DesignedbyAmpersand/ParulaKeyboard/README.md

Parula is a 100x49mm USB keyboard with 66 keys.

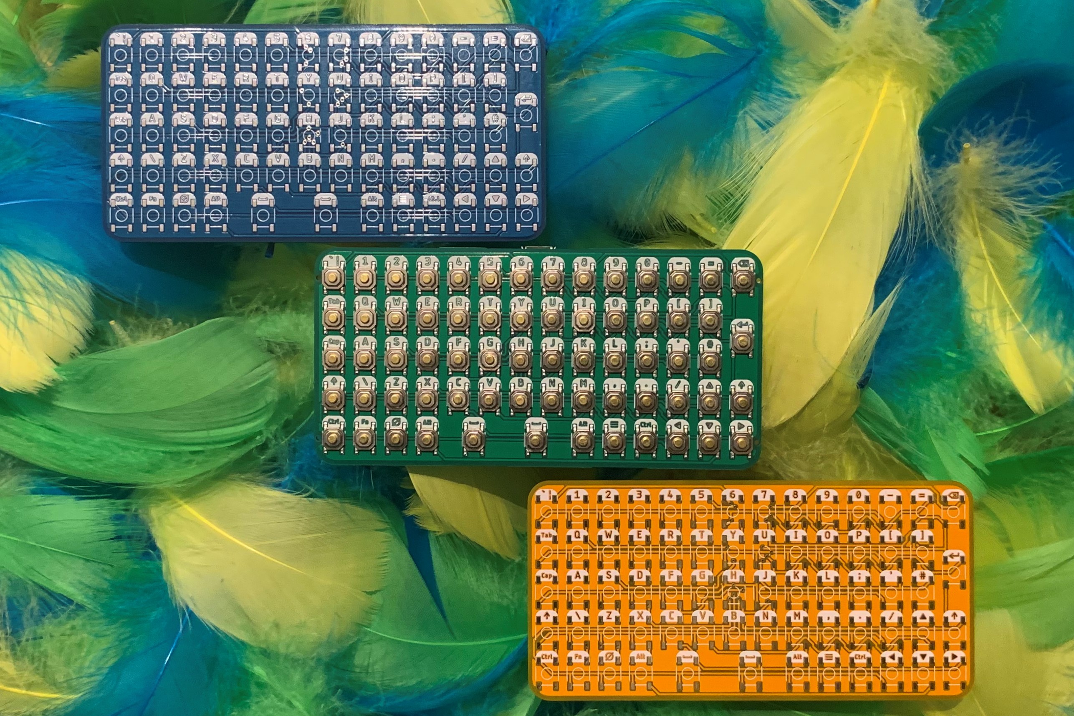
[picture p1: photos/IMG_1236cropped.jpg]
Front


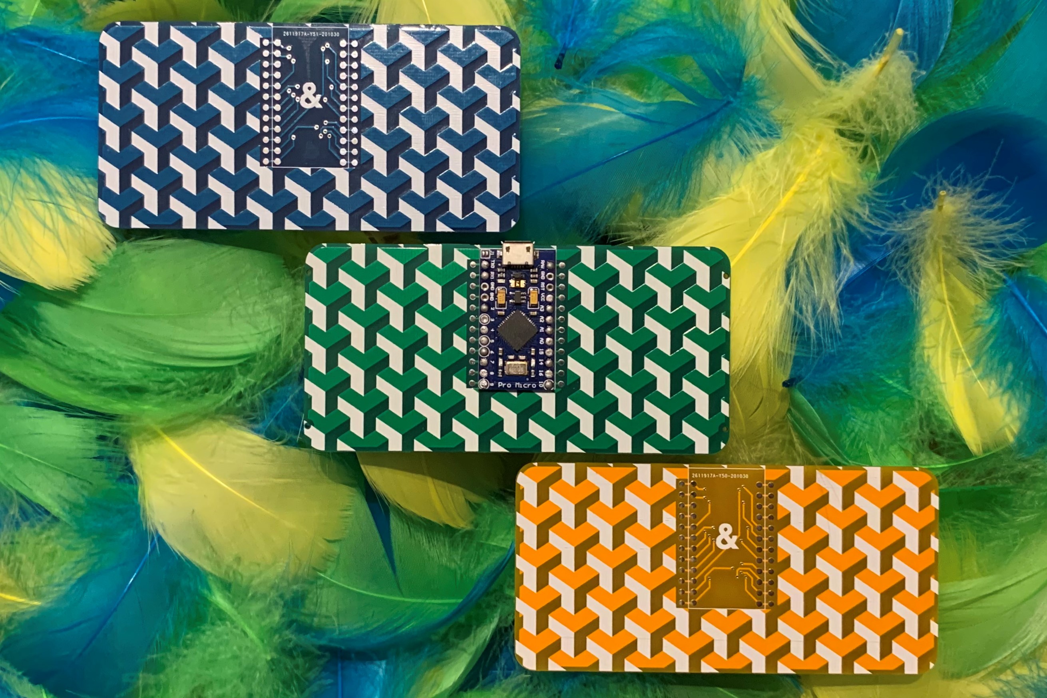
[picture p2: photos/IMG_1222cropped.jpg]
Back
