DesignedbyAmpersand/ParulaKeyboard/Parula Files V1/Parula Keymap.png

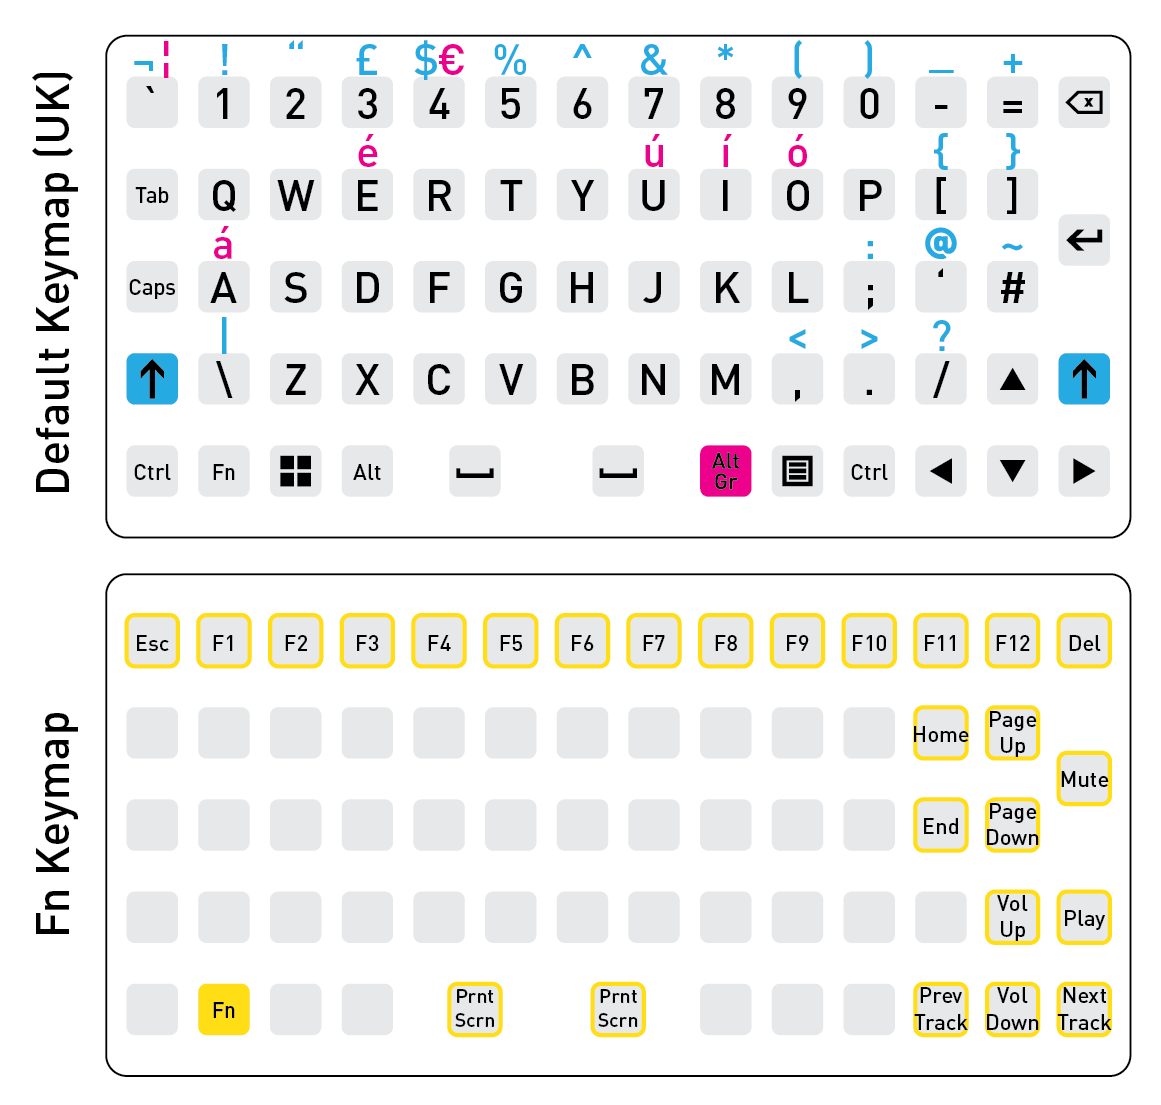
Parula Files V1/Parula Keymap.png
