DesignedbyAmpersand/ParulaKeyboard/photos/IMG_1177cropped.jpg

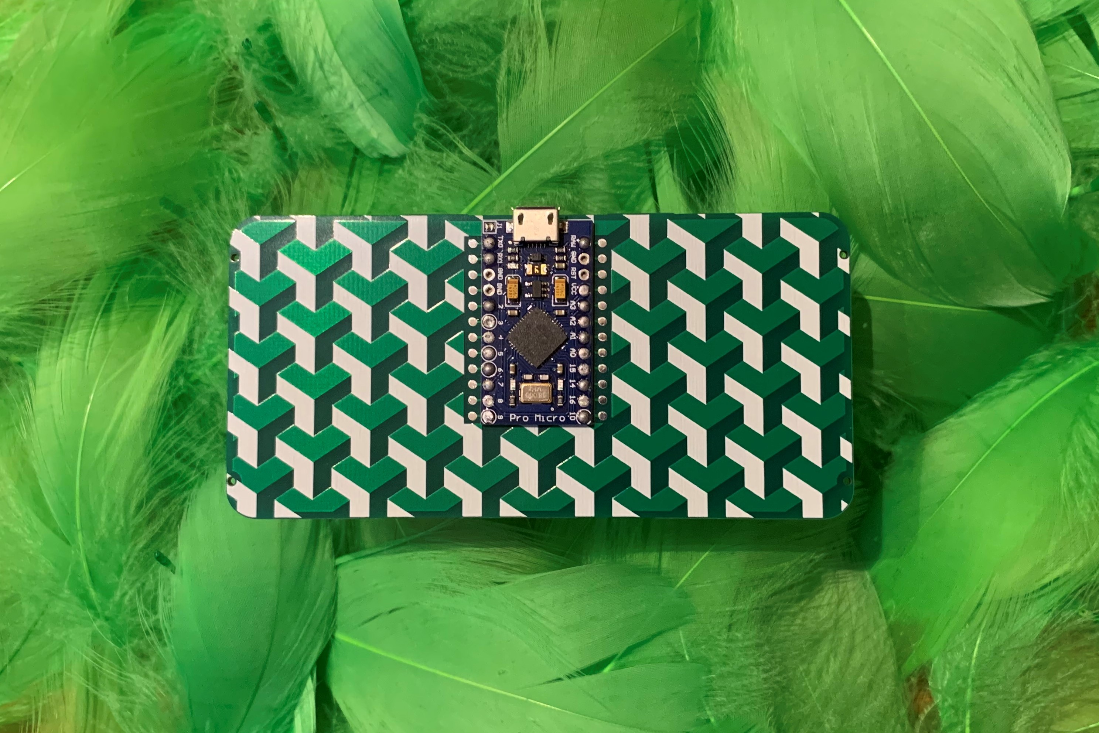
photos/IMG_1177cropped.jpg
