DesignedbyAmpersand/ParulaKeyboard/photos/IMG_1180cropped.jpg

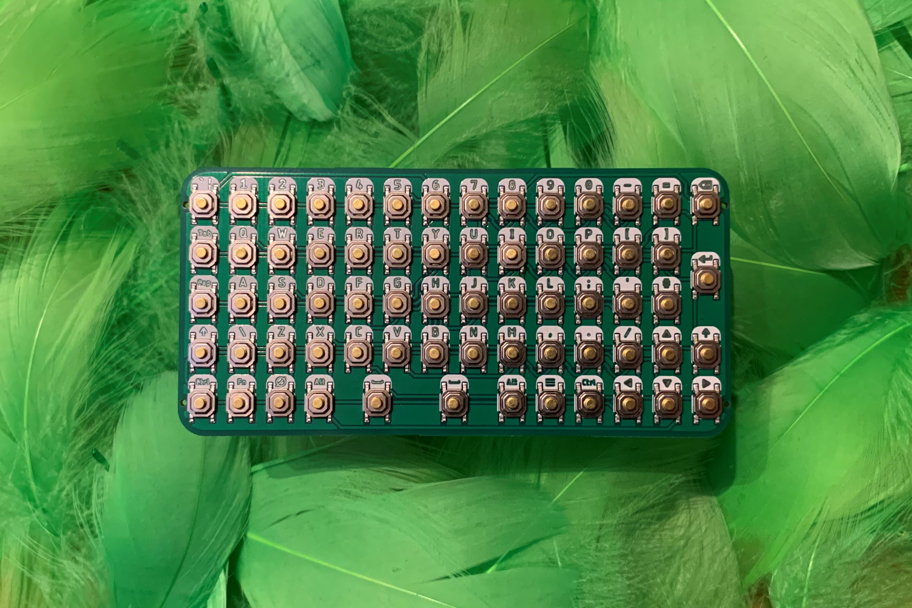
photos/IMG_1180cropped.jpg
