DesignedbyAmpersand/ParulaKeyboard/photos/IMG_1192cropped.jpg

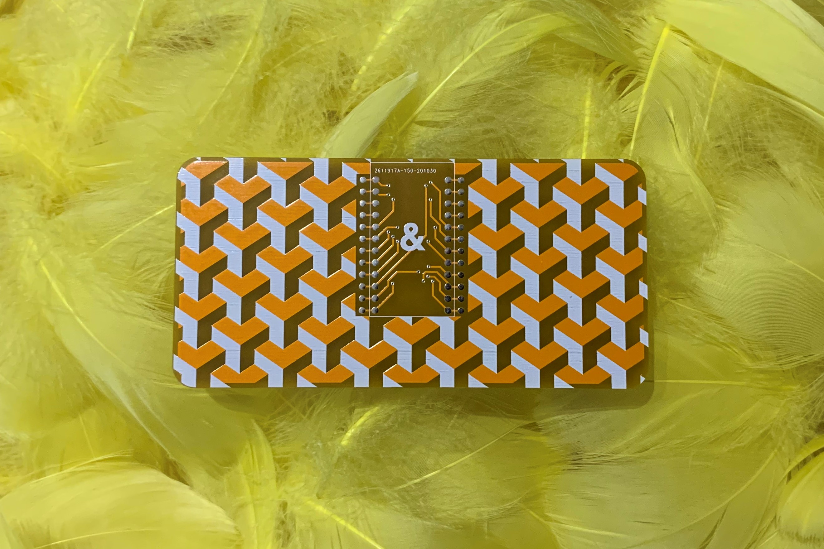
photos/IMG_1192cropped.jpg
