DesignedbyAmpersand/ParulaKeyboard/photos/IMG_1197cropped.jpg

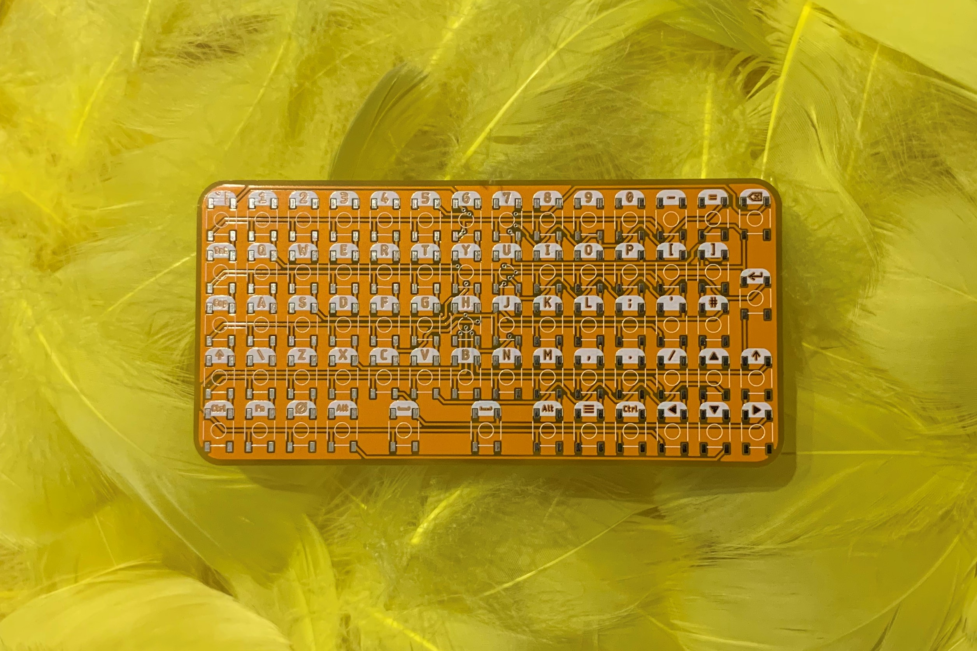
photos/IMG_1197cropped.jpg
