DesignedbyAmpersand/ParulaKeyboard/photos/IMG_1205cropped.jpg

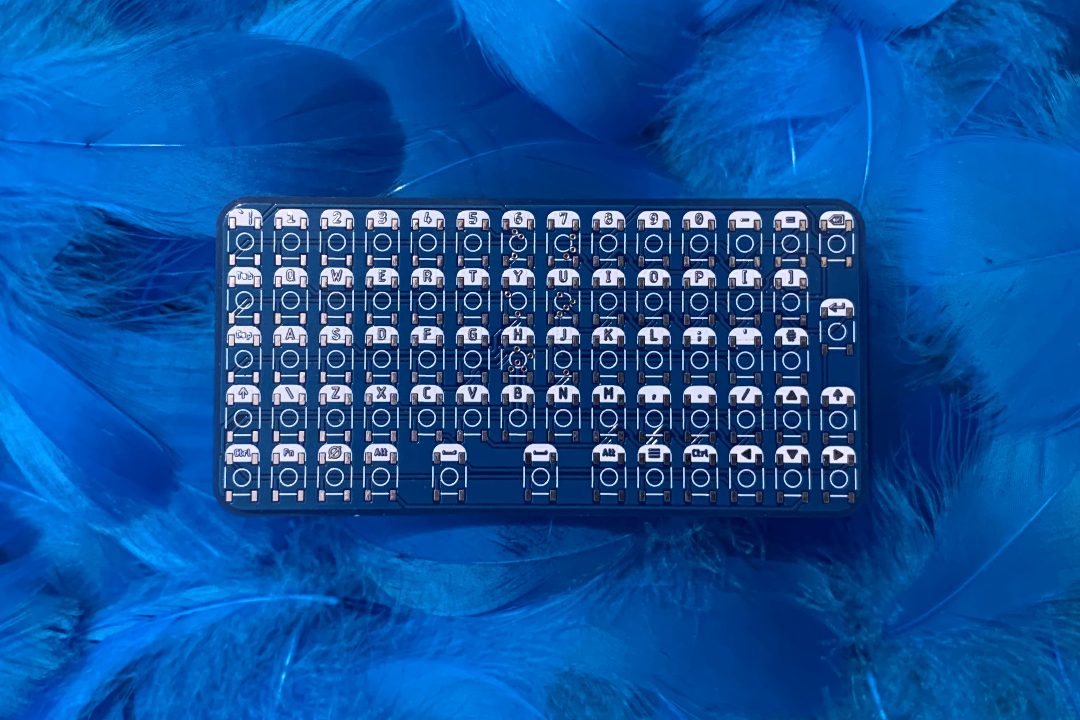
photos/IMG_1205cropped.jpg
