DesignedbyAmpersand/ParulaKeyboard/photos/IMG_1210cropped.jpg

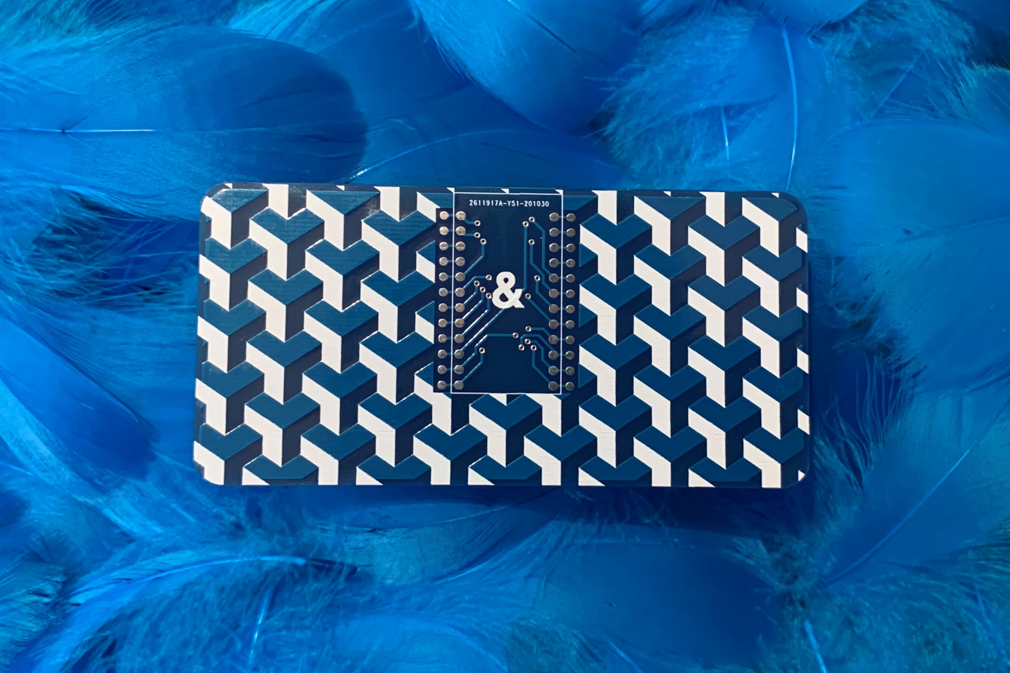
photos/IMG_1210cropped.jpg
