DesignedbyAmpersand/ParulaKeyboard/PCB/Keyboard V3.4 no holes.brd

## EAGLE design PCB/Keyboard V3.4 no holes.brd (2025-06-03)

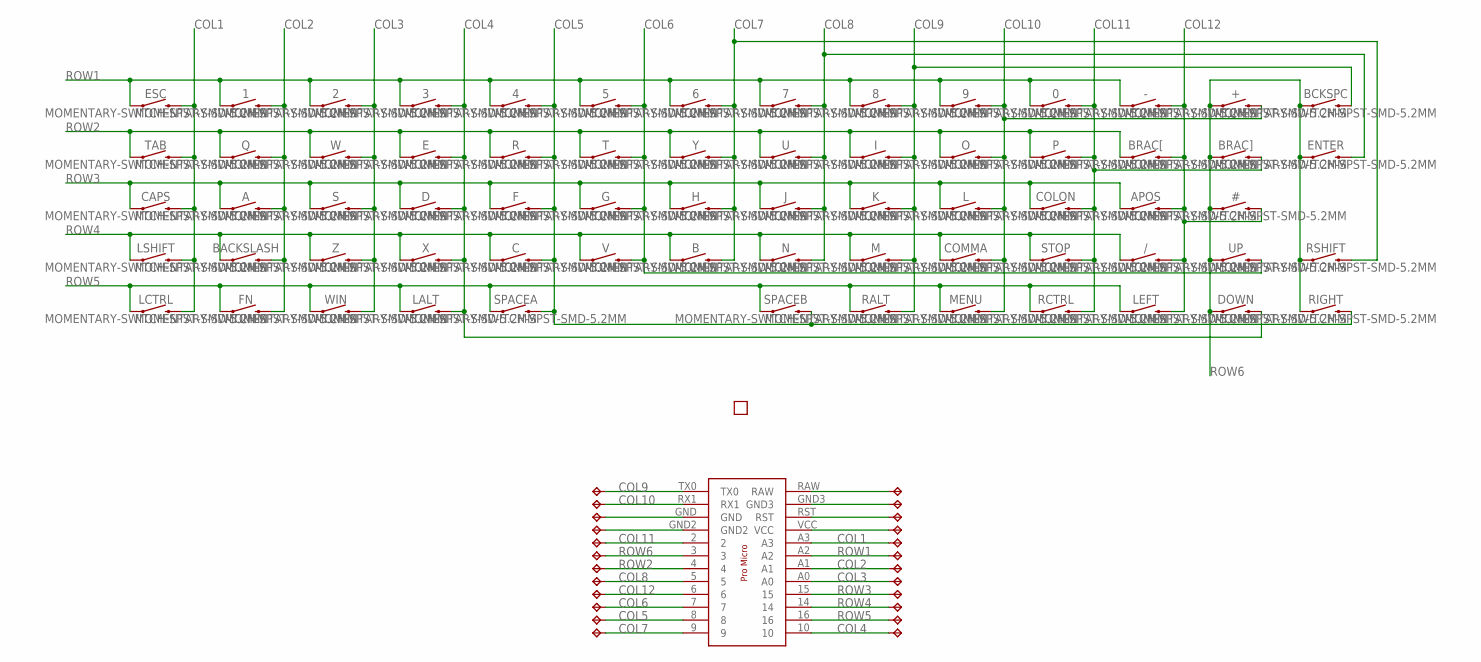
[picture p21: schematic Keyboard V3.4 no holes.sch]

Parts:
0, 1, 2, 3, 4, 5, 6, 7, 8, 9: MOMENTARY-SWITCH-SPST-SMD-5.2MM; TACTILE_SWITCH_SMD_5.2MM
#: MOMENTARY-SWITCH-SPST-SMD-5.2MM; TACTILE_SWITCH_SMD_5.2MM
+: MOMENTARY-SWITCH-SPST-SMD-5.2MM; TACTILE_SWITCH_SMD_5.2MM
-: MOMENTARY-SWITCH-SPST-SMD-5.2MM; TACTILE_SWITCH_SMD_5.2MM
/: MOMENTARY-SWITCH-SPST-SMD-5.2MM; TACTILE_SWITCH_SMD_5.2MM
A: MOMENTARY-SWITCH-SPST-SMD-5.2MM; TACTILE_SWITCH_SMD_5.2MM
APOS: MOMENTARY-SWITCH-SPST-SMD-5.2MM; TACTILE_SWITCH_SMD_5.2MM
B: MOMENTARY-SWITCH-SPST-SMD-5.2MM; TACTILE_SWITCH_SMD_5.2MM
BACKSLASH: MOMENTARY-SWITCH-SPST-SMD-5.2MM; TACTILE_SWITCH_SMD_5.2MM
BCKSPC: MOMENTARY-SWITCH-SPST-SMD-5.2MM; TACTILE_SWITCH_SMD_5.2MM
BRAC[: MOMENTARY-SWITCH-SPST-SMD-5.2MM; TACTILE_SWITCH_SMD_5.2MM
BRAC]: MOMENTARY-SWITCH-SPST-SMD-5.2MM; TACTILE_SWITCH_SMD_5.2MM
C: MOMENTARY-SWITCH-SPST-SMD-5.2MM; TACTILE_SWITCH_SMD_5.2MM
CAPS: MOMENTARY-SWITCH-SPST-SMD-5.2MM; TACTILE_SWITCH_SMD_5.2MM
COLON: MOMENTARY-SWITCH-SPST-SMD-5.2MM; TACTILE_SWITCH_SMD_5.2MM
COMMA: MOMENTARY-SWITCH-SPST-SMD-5.2MM; TACTILE_SWITCH_SMD_5.2MM
D: MOMENTARY-SWITCH-SPST-SMD-5.2MM; TACTILE_SWITCH_SMD_5.2MM
DOWN: MOMENTARY-SWITCH-SPST-SMD-5.2MM; TACTILE_SWITCH_SMD_5.2MM
E: MOMENTARY-SWITCH-SPST-SMD-5.2MM; TACTILE_SWITCH_SMD_5.2MM
ENTER: MOMENTARY-SWITCH-SPST-SMD-5.2MM; TACTILE_SWITCH_SMD_5.2MM
ESC: MOMENTARY-SWITCH-SPST-SMD-5.2MM; TACTILE_SWITCH_SMD_5.2MM
F: MOMENTARY-SWITCH-SPST-SMD-5.2MM; TACTILE_SWITCH_SMD_5.2MM
FN: MOMENTARY-SWITCH-SPST-SMD-5.2MM; TACTILE_SWITCH_SMD_5.2MM
G: MOMENTARY-SWITCH-SPST-SMD-5.2MM; TACTILE_SWITCH_SMD_5.2MM
H: MOMENTARY-SWITCH-SPST-SMD-5.2MM; TACTILE_SWITCH_SMD_5.2MM
I: MOMENTARY-SWITCH-SPST-SMD-5.2MM; TACTILE_SWITCH_SMD_5.2MM
J: MOMENTARY-SWITCH-SPST-SMD-5.2MM; TACTILE_SWITCH_SMD_5.2MM
K: MOMENTARY-SWITCH-SPST-SMD-5.2MM; TACTILE_SWITCH_SMD_5.2MM
L: MOMENTARY-SWITCH-SPST-SMD-5.2MM; TACTILE_SWITCH_SMD_5.2MM
LALT: MOMENTARY-SWITCH-SPST-SMD-5.2MM; TACTILE_SWITCH_SMD_5.2MM
LCTRL: MOMENTARY-SWITCH-SPST-SMD-5.2MM; TACTILE_SWITCH_SMD_5.2MM
LEFT: MOMENTARY-SWITCH-SPST-SMD-5.2MM; TACTILE_SWITCH_SMD_5.2MM
LSHIFT: MOMENTARY-SWITCH-SPST-SMD-5.2MM; TACTILE_SWITCH_SMD_5.2MM
M: MOMENTARY-SWITCH-SPST-SMD-5.2MM; TACTILE_SWITCH_SMD_5.2MM
MENU: MOMENTARY-SWITCH-SPST-SMD-5.2MM; TACTILE_SWITCH_SMD_5.2MM
N: MOMENTARY-SWITCH-SPST-SMD-5.2MM; TACTILE_SWITCH_SMD_5.2MM
O: MOMENTARY-SWITCH-SPST-SMD-5.2MM; TACTILE_SWITCH_SMD_5.2MM
P: MOMENTARY-SWITCH-SPST-SMD-5.2MM; TACTILE_SWITCH_SMD_5.2MM
Q: MOMENTARY-SWITCH-SPST-SMD-5.2MM; TACTILE_SWITCH_SMD_5.2MM
R: MOMENTARY-SWITCH-SPST-SMD-5.2MM; TACTILE_SWITCH_SMD_5.2MM
RALT: MOMENTARY-SWITCH-SPST-SMD-5.2MM; TACTILE_SWITCH_SMD_5.2MM
RCTRL: MOMENTARY-SWITCH-SPST-SMD-5.2MM; TACTILE_SWITCH_SMD_5.2MM
RIGHT: MOMENTARY-SWITCH-SPST-SMD-5.2MM; TACTILE_SWITCH_SMD_5.2MM
RSHIFT: MOMENTARY-SWITCH-SPST-SMD-5.2MM; TACTILE_SWITCH_SMD_5.2MM
S: MOMENTARY-SWITCH-SPST-SMD-5.2MM; TACTILE_SWITCH_SMD_5.2MM
SPACEA: MOMENTARY-SWITCH-SPST-SMD-5.2MM; TACTILE_SWITCH_SMD_5.2MM
SPACEB: MOMENTARY-SWITCH-SPST-SMD-5.2MM; TACTILE_SWITCH_SMD_5.2MM
STOP: MOMENTARY-SWITCH-SPST-SMD-5.2MM; TACTILE_SWITCH_SMD_5.2MM
T: MOMENTARY-SWITCH-SPST-SMD-5.2MM; TACTILE_SWITCH_SMD_5.2MM
TAB: MOMENTARY-SWITCH-SPST-SMD-5.2MM; TACTILE_SWITCH_SMD_5.2MM
TP1, TP2, TP3, TP4, TP5, TP6, TP7, TP8, TP9, TP10, TP11, TP12, TP13, TP14, TP15, TP16, TP17, TP18, TP19, TP20, TP21, TP22, TP23, TP24: TPTP14R; TP14R
U: MOMENTARY-SWITCH-SPST-SMD-5.2MM; TACTILE_SWITCH_SMD_5.2MM
U$1: PEANUT-PRO-MICRO; PRO-MICRO
U$3: AMP-HALF
UP: MOMENTARY-SWITCH-SPST-SMD-5.2MM; TACTILE_SWITCH_SMD_5.2MM
V: MOMENTARY-SWITCH-SPST-SMD-5.2MM; TACTILE_SWITCH_SMD_5.2MM
W: MOMENTARY-SWITCH-SPST-SMD-5.2MM; TACTILE_SWITCH_SMD_5.2MM
WIN: MOMENTARY-SWITCH-SPST-SMD-5.2MM; TACTILE_SWITCH_SMD_5.2MM
X: MOMENTARY-SWITCH-SPST-SMD-5.2MM; TACTILE_SWITCH_SMD_5.2MM
Y: MOMENTARY-SWITCH-SPST-SMD-5.2MM; TACTILE_SWITCH_SMD_5.2MM
Z: MOMENTARY-SWITCH-SPST-SMD-5.2MM; TACTILE_SWITCH_SMD_5.2MM

Connections:
COL1: CAPS.3 (2), CAPS.4 (2), ESC.3 (2), ESC.4 (2), LCTRL.3 (2), LCTRL.4 (2), LSHIFT.3 (2), LSHIFT.4 (2), TAB.3 (2), TAB.4 (2), TP8.TP, U$1.A3
COL2: 1.3 (2), 1.4 (2), A.3 (2), A.4 (2), BACKSLASH.3 (2), BACKSLASH.4 (2), FN.3 (2), FN.4 (2), Q.3 (2), Q.4 (2), TP6.TP, U$1.A1
COL3: 2.3 (2), 2.4 (2), S.3 (2), S.4 (2), TP5.TP, U$1.A0, W.3 (2), W.4 (2), WIN.3 (2), WIN.4 (2), Z.3 (2), Z.4 (2)
COL4: 3.3 (2), 3.4 (2), D.3 (2), D.4 (2), DOWN.3 (2), DOWN.4 (2), E.3 (2), E.4 (2), LALT.3 (2), LALT.4 (2), TP2.TP, U$1.10, X.3 (2), X.4 (2)
COL5: 4.3 (2), 4.4 (2), C.3 (2), C.4 (2), F.3 (2), F.4 (2), R.3 (2), R.4 (2), RIGHT.3 (2), RIGHT.4 (2), SPACEA.3 (2), SPACEA.4 (2), SPACEB.3 (2), SPACEB.4 (2), TP17.TP, U$1.8
COL6: 5.3 (2), 5.4 (2), G.3 (2), G.4 (2), T.3 (2), T.4 (2), TP16.TP, U$1.7, UP.3 (2), UP.4 (2), V.3 (2), V.4 (2)
COL7: 6.3 (2), 6.4 (2), B.3 (2), B.4 (2), H.3 (2), H.4 (2), RSHIFT.3 (2), RSHIFT.4 (2), TP18.TP, U$1.9, Y.3 (2), Y.4 (2)
COL8: 7.3 (2), 7.4 (2), ENTER.3 (2), ENTER.4 (2), J.3 (2), J.4 (2), N.3 (2), N.4 (2), TP14.TP, U.3 (2), U.4 (2), U$1.5
COL9: 8.3 (2), 8.4 (2), BCKSPC.3 (2), BCKSPC.4 (2), I.3 (2), I.4 (2), K.3 (2), K.4 (2), M.3 (2), M.4 (2), RALT.3 (2), RALT.4 (2), TP9.TP, U$1.TX0
COL10: 9.3 (2), 9.4 (2), +.3 (2), +.4 (2), COMMA.3 (2), COMMA.4 (2), L.3 (2), L.4 (2), MENU.3 (2), MENU.4 (2), O.3 (2), O.4 (2), TP10.TP, U$1.RX1
COL11: 0.3 (2), 0.4 (2), BRAC].3 (2), BRAC].4 (2), COLON.3 (2), COLON.4 (2), P.3 (2), P.4 (2), RCTRL.3 (2), RCTRL.4 (2), STOP.3 (2), STOP.4 (2), TP11.TP, U$1.2
COL12: #.3 (2), #.4 (2), -.3 (2), -.4 (2), /.3 (2), /.4 (2), APOS.3 (2), APOS.4 (2), BRAC[.3 (2), BRAC[.4 (2), LEFT.3 (2), LEFT.4 (2), TP15.TP, U$1.6
unnamed: TP20.TP, U$1.GND
unnamed: TP19.TP, U$1.GND2
unnamed: TP24.TP, U$1.RAW
unnamed: TP23.TP, U$1.GND3
unnamed: TP22.TP, U$1.RST
unnamed: TP21.TP, U$1.VCC
ROW1: 0.1, 0.2 (1), 1.1, 1.2 (1), 2.1, 2.2 (1), 3.1, 3.2 (1), 4.1, 4.2 (1), 5.1, 5.2 (1), 6.1, 6.2 (1), 7.1, 7.2 (1), 8.1, 8.2 (1), 9.1, 9.2 (1), -.1, -.2 (1), ESC.1, ESC.2 (1), TP7.TP, U$1.A2
ROW2: BRAC[.1, BRAC[.2 (1), E.1, E.2 (1), I.1, I.2 (1), O.1, O.2 (1), P.1, P.2 (1), Q.1, Q.2 (1), R.1, R.2 (1), T.1, T.2 (1), TAB.1, TAB.2 (1), TP13.TP, U.1, U.2 (1), U$1.4, W.1, W.2 (1), Y.1, Y.2 (1)
ROW3: A.1, A.2 (1), APOS.1, APOS.2 (1), CAPS.1, CAPS.2 (1), COLON.1, COLON.2 (1), D.1, D.2 (1), F.1, F.2 (1), G.1, G.2 (1), H.1, H.2 (1), J.1, J.2 (1), K.1, K.2 (1), L.1, L.2 (1), S.1, S.2 (1), TP4.TP, U$1.15
ROW4: /.1, /.2 (1), B.1, B.2 (1), BACKSLASH.1, BACKSLASH.2 (1), C.1, C.2 (1), COMMA.1, COMMA.2 (1), LSHIFT.1, LSHIFT.2 (1), M.1, M.2 (1), N.1, N.2 (1), STOP.1, STOP.2 (1), TP3.TP, U$1.14, V.1, V.2 (1), X.1, X.2 (1), Z.1, Z.2 (1)
ROW5: FN.1, FN.2 (1), LALT.1, LALT.2 (1), LCTRL.1, LCTRL.2 (1), LEFT.1, LEFT.2 (1), MENU.1, MENU.2 (1), RALT.1, RALT.2 (1), RCTRL.1, RCTRL.2 (1), SPACEA.1, SPACEA.2 (1), SPACEB.1, SPACEB.2 (1), TP1.TP, U$1.16, WIN.1, WIN.2 (1)
ROW6: #.1, #.2 (1), +.1, +.2 (1), BCKSPC.1, BCKSPC.2 (1), BRAC].1, BRAC].2 (1), DOWN.1, DOWN.2 (1), ENTER.1, ENTER.2 (1), RIGHT.1, RIGHT.2 (1), RSHIFT.1, RSHIFT.2 (1), TP12.TP, U$1.3, UP.1, UP.2 (1)

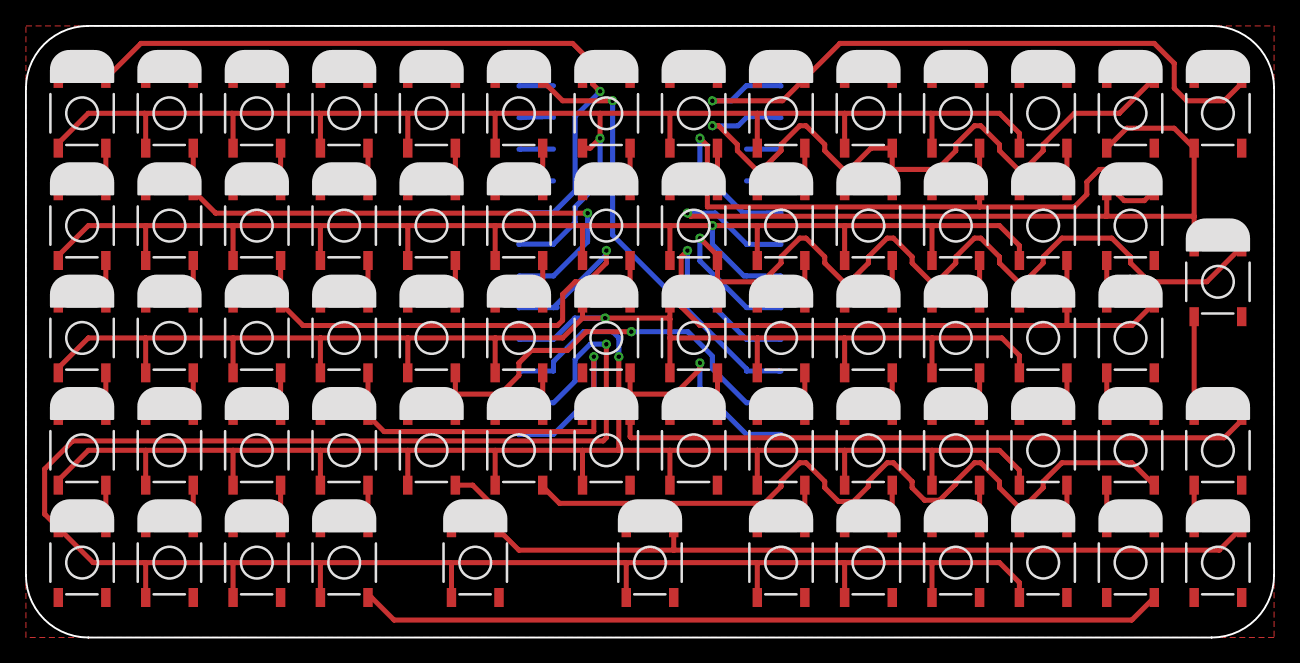
[picture p22: board Keyboard V3.4 no holes.brd from above]

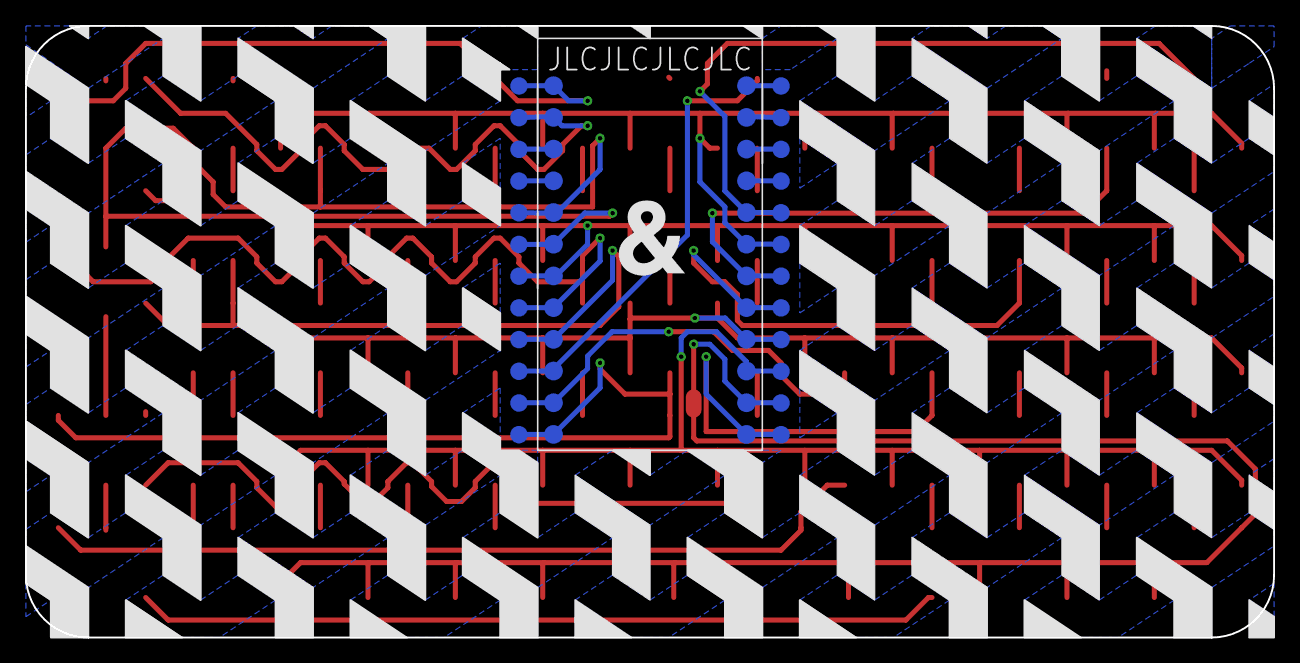
[picture p23: board Keyboard V3.4 no holes.brd from below]

Board: 2 copper layers, 100.0 x 49.0 mm, 93 parts (26 on the bottom side), 24 nets.
